bee-eater/SIEDLE-Smart-ESP8266/Media/IMG_5097.JPG

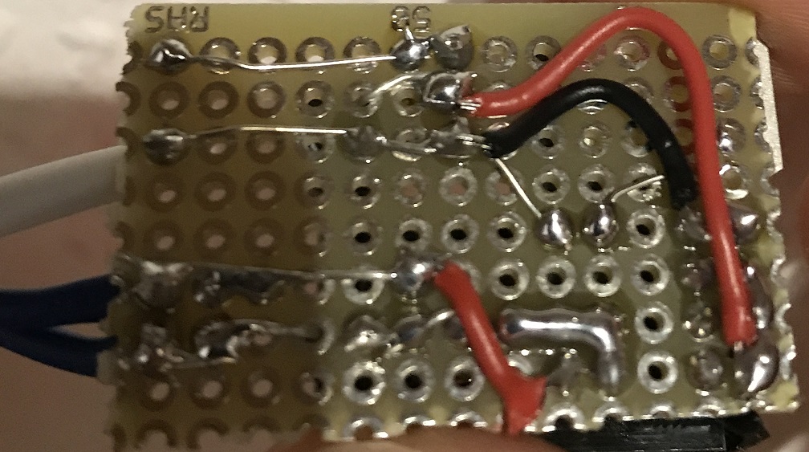
Media/IMG_5097.JPG
