bee-eater/SIEDLE-Smart-ESP8266/Media/IMG_5098.JPG

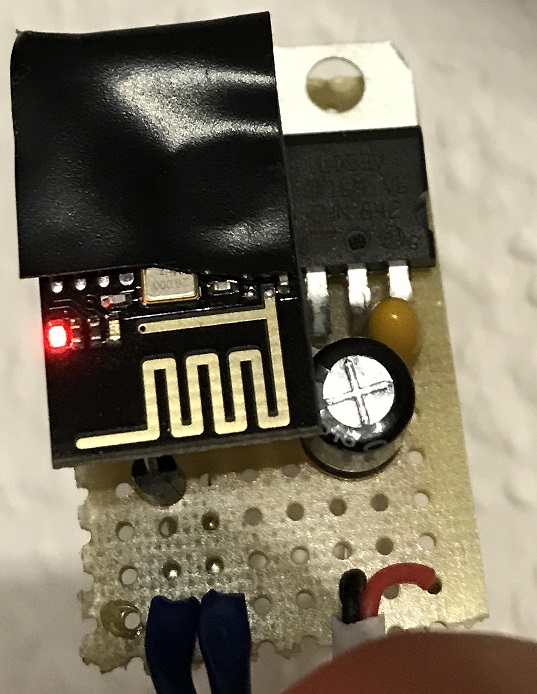
Media/IMG_5098.JPG
