bee-eater/SIEDLE-Smart-ESP8266/Media/IMG_5100.JPG

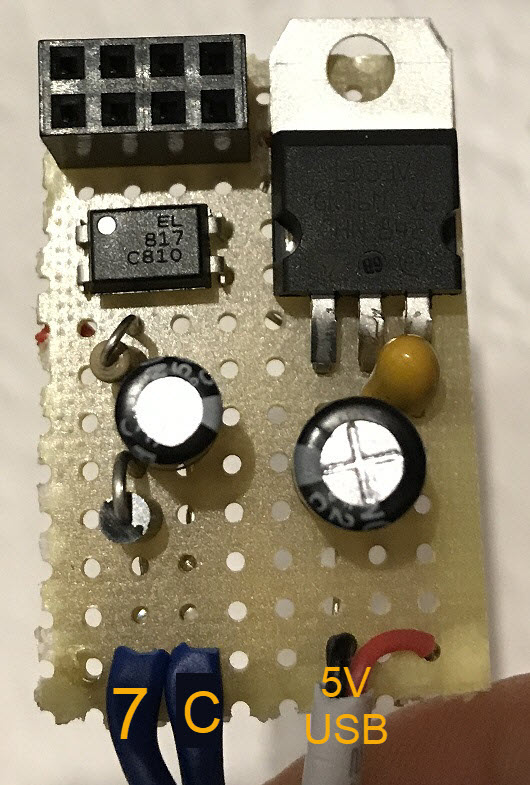
Media/IMG_5100.JPG
