bee-eater/SIEDLE-Smart-ESP8266/Media/IMG_5101.JPG

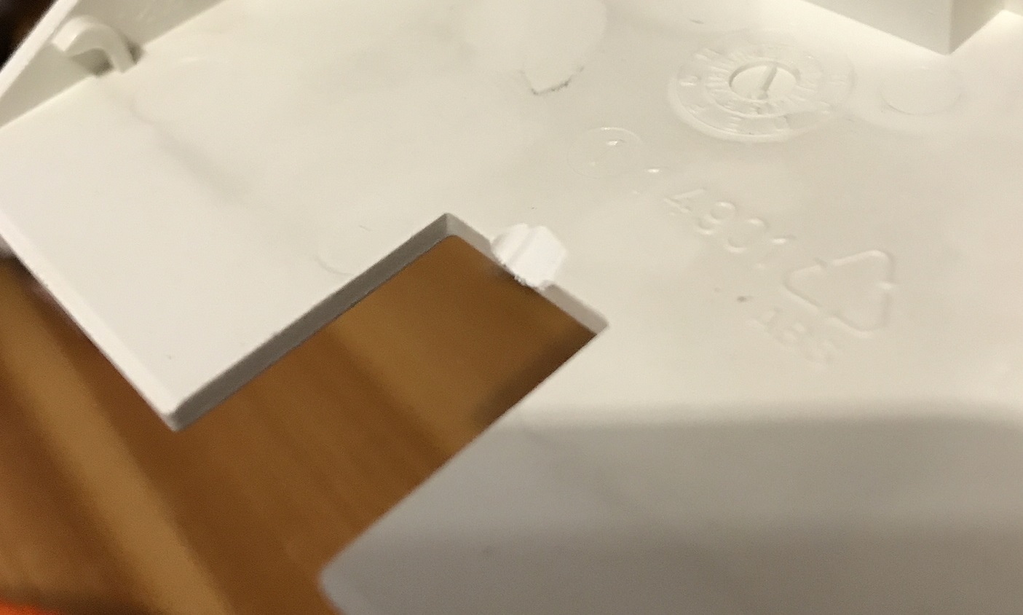
Media/IMG_5101.JPG
