bee-eater/SIEDLE-Smart-ESP8266/Hardware/LTSpice/ESP_Siedle.asc

C1: cap; 10µ
D1: diode; 1N4007
R1: res; 2k2
R2: res; 30k
U1: PC817A
V1: voltage; SINE(0 12 50 0)
V2: voltage; 3.3
Named nets: 0
.tran 100ms
