bee-eater/SIEDLE-Smart-ESP8266/Hardware/Schematics/SiedleESP.kicad_pcb

## KiCad design mixer.sch

Schematic: mixer.sch

Parts:
J1: AudioJack3_Ground
RV1: 47k

Notes on the sheet:
NJM2505A
